grzechot/Zcythe.stone/cad/README.md

# cad

CAD sources (STEP for any CAD, optionally native .pk2). To be added.
