grzechot/Zcythe.stone/stl/K1Flag.stl

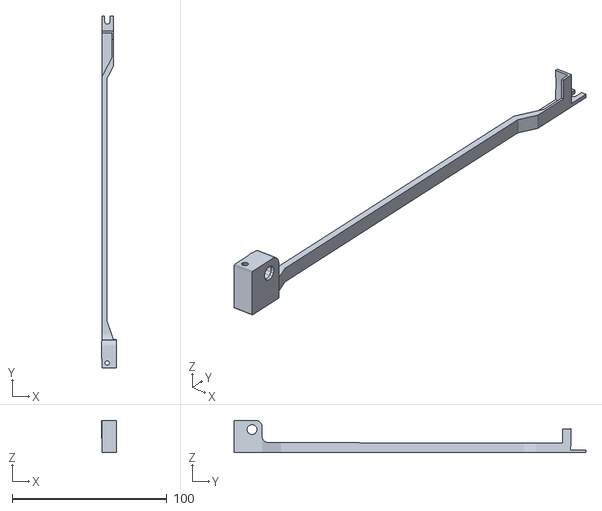
[picture p3: CAD file, 2026-10-26]
stl/K1Flag.stl
9.90 x 227.2 x 20.8
