grzechot/Zcythe.stone/stl/v1/K1Flag.stl

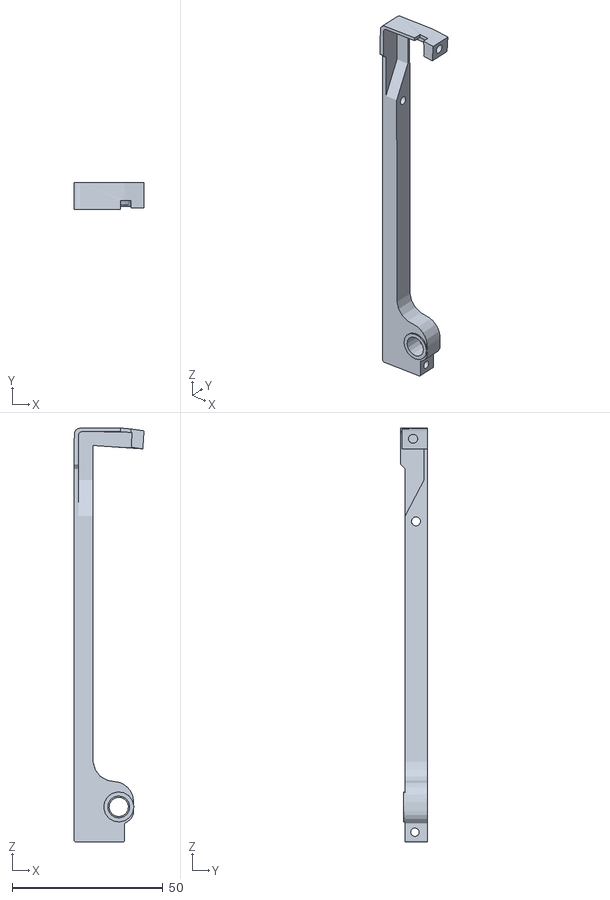
[picture p4: CAD file, 2026-10-20]
stl/v1/K1Flag.stl
23.3 x 8.90 x 137.4
