grzechot/Zcythe.stone/stl/K1Support.stl

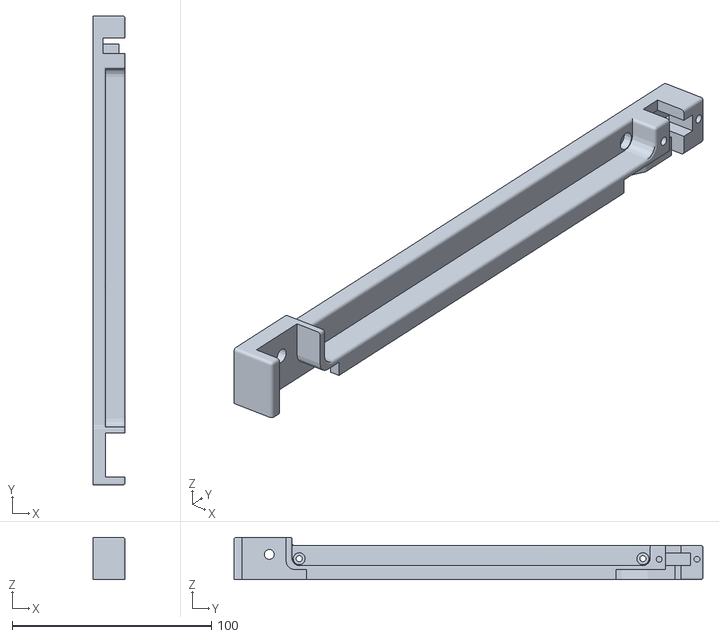
[picture p5: CAD file, 2026-10-26]
stl/K1Support.stl
16.2 x 235.4 x 21.2
