grzechot/Zcythe.stone/stl/v1/K1Support.stl

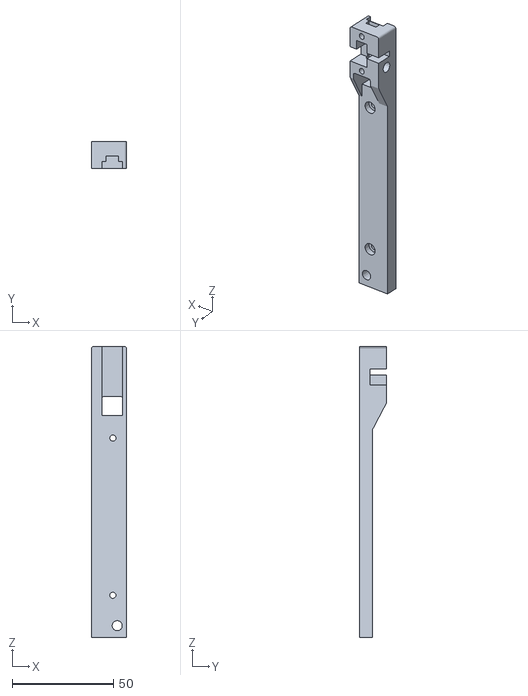
[picture p6: CAD file, 2026-10-20]
stl/v1/K1Support.stl
17.2 x 13.2 x 143.5
