grzechot/Zcythe.stone/(commit log)

2026-10-20 Zcythe Stone: README (EN), placeholders for STL and photos
2026-10-20 Layout: stl/, cad/, pic/
2026-10-20 Parts as in Zcythe; tip = M3 screw with a rounded head (also the height adjustment)
2026-10-20 Assembly instructions (as Zcythe, M3 rounded-head screw instead of the ball); dead-zone screw marked untested
2026-10-20 README: target printers, requirements (nozzle +15 mm beyond the bed), measured accuracy, diagnostics
2026-10-22 README: delta, Klipper, Marlin marked untested instead of unsupported
2026-10-26 Stone K1 new version: long lever 14 : 200 mm along the bed edge
2026-10-26 Versions v1 / v2 (3x8x4 bearings), work in progress note
2026-10-26 v2 STL (K1Flag, K1Support), v1 STL moved to stl/v1, photos of v1 and v2
    [K1Flag.stl, K1Support.stl]
